blipworks/trilife/README.md

trilife
=======

Code and design files for Trilife cellular automata blinking LED project.
Initial work supported by the National Science Foundation under
Grant No. 0644511.
