blipworks/trilife/PCB/Board_file_info.txt

Board file descriptions
Board revisions through the current version 1.3 are all inter-compatible in a single Trilife array and use the same bill of materials. Eagle 6 format.

IndividualTrilife_1_3.brd and .sch: Single version 1.3 board with improved LED silkscreen, and schematic

ConnectorBoard.brd : use one per every 2 trilife boards (of any version) if you want to create a rigid hexagonal array, instead of using jumper wires

ConnectorBoardWithPowerJack.brd : Has a power jack, but otherwise works like the ConnectorBoard. Traces and components are designed for a max of 4A 

Older files
Trilife1 board and schematic in Eagle 6.0. This is a single board and a power connector.

Trilife5 board; this is an array of the Trilife 1 that fits in the maximum free Eagle footprint and can be cut apart with PCB chopper--board and schematic aren't consistent because there are multiple copies.

Trilife5 Zipped files are the Gerber files to send to the board manufacturer for the arrayed board.
