blipworks/trilife/BuildInstructions/TrianglePaperPixel.pdf

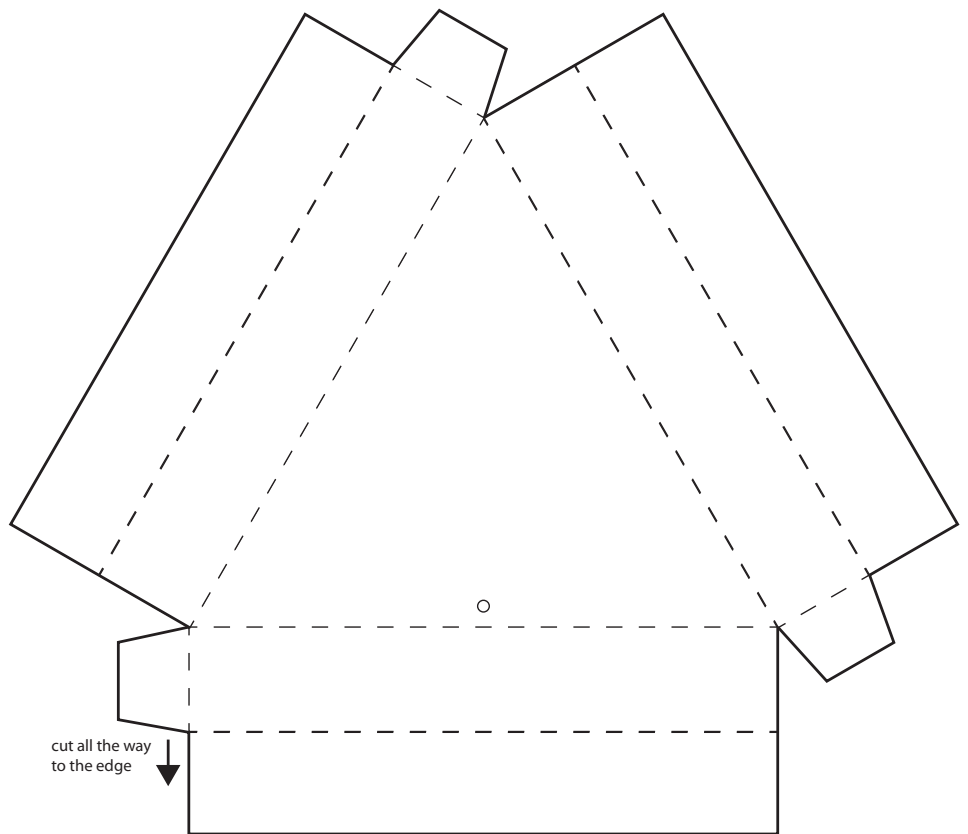
[picture p1: page 1]

cut all the way
to the edge
