blipworks/trilife/PCB/IndividualTrilife_1_3.brd

## EAGLE design PCB/IndividualTrilife_1_3.brd (2012-09-24)

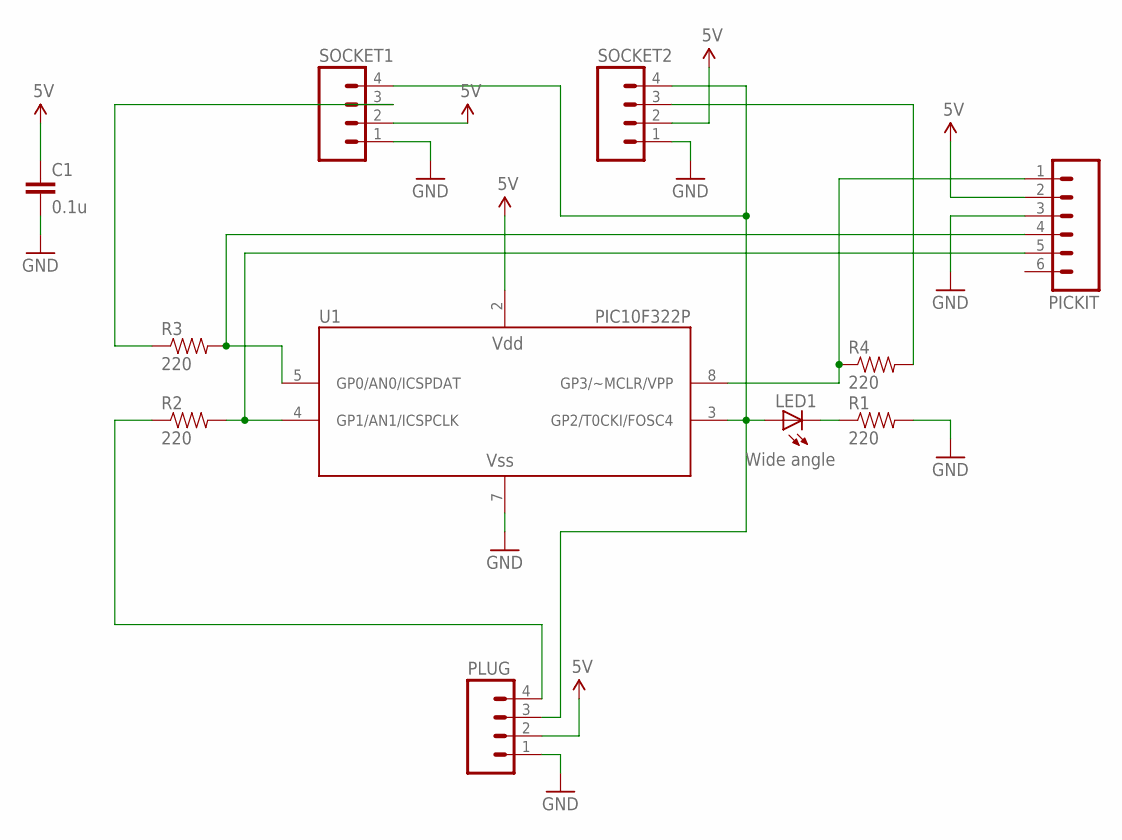
[picture p2: schematic IndividualTrilife_1_3.sch]

Parts:
C1: 0.1u; CAP-PTH-SMALL
LED1: Wide angle; LED5MM
PICKIT: M06LOCK; 1X06_LOCK
PLUG: M04LOCK; 1X04_LOCK
R1, R2, R3, R4: 220; AXIAL-0.4
SOCKET1, SOCKET2: M04LOCK; 1X04_LOCK
U1: PIC10F322P; DIP-8

Connections:
5V: C1.1, PICKIT.2, PLUG.2, SOCKET1.2, SOCKET2.2, U1.2 (VDD)
GND: C1.2, PICKIT.3, PLUG.1, R1.P$2 (2), SOCKET1.1, SOCKET2.1, U1.7 (VSS)
unnamed: LED1.A, PLUG.3, SOCKET1.4, SOCKET2.4, U1.3 (GP2/T0CKI/FOSC4)
unnamed: LED1.K (C), R1.P$1 (1)
unnamed: PICKIT.1, R4.P$1 (1), U1.8 (GP3/~MCLR/VPP)
unnamed: PICKIT.4, R3.P$2 (2), U1.5 (GP0/AN0/ICSPDAT)
unnamed: PICKIT.5, R2.P$2 (2), U1.4 (GP1/AN1/ICSPCLK)
unnamed: R4.P$2 (2), SOCKET2.3
unnamed: R3.P$1 (1), SOCKET1.3
unnamed: PLUG.4, R2.P$1 (1)

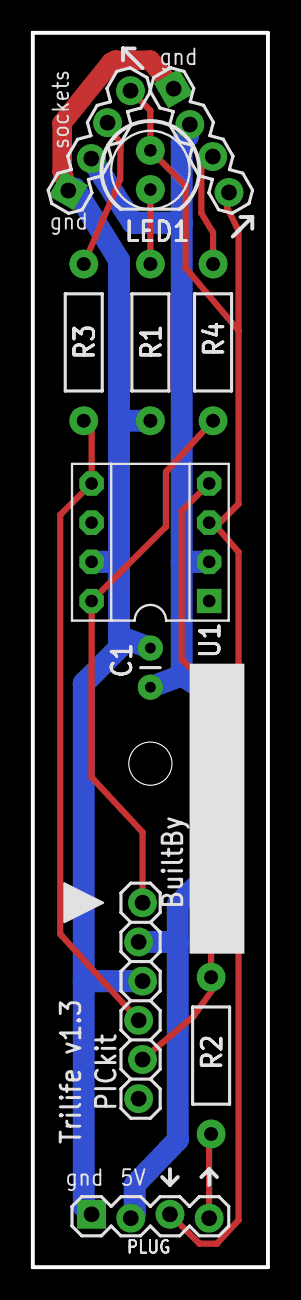
[picture p3: board IndividualTrilife_1_3.brd from above]

Board: 2 copper layers, 15.2 x 80.0 mm, 11 parts (0 on the bottom side), 10 nets.
