blipworks/trilife/PCB/Trilife_1.brd

## EAGLE design PCB/Trilife_1.brd (2012-04-29)

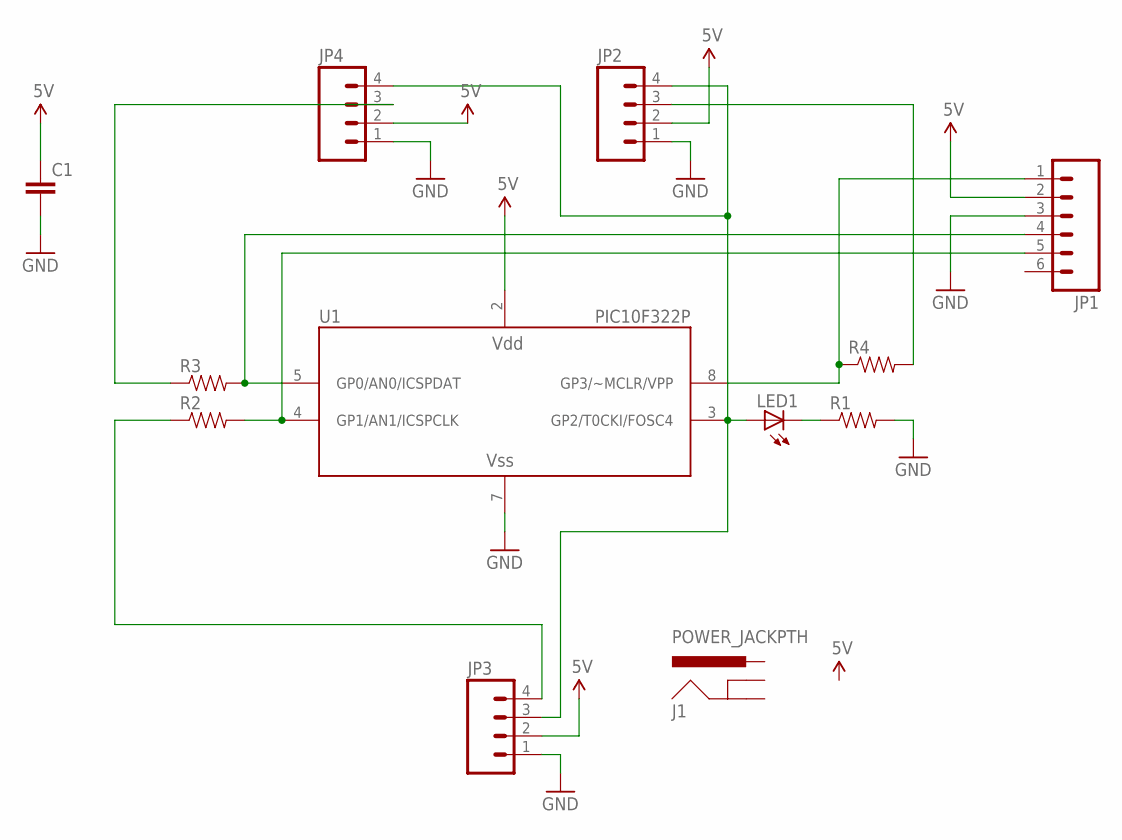
[picture p4: schematic Trilife_1.sch]

Parts:
C1: CAPPTH; CAP-PTH-SMALL
J1: POWER_JACKPTH; POWER_JACK_PTH
JP1: M06LOCK; 1X06_LOCK
JP2, JP3, JP4: M04LOCK; 1X04_LOCK
LED1: LED5MM
R1, R2, R3, R4: RESISTORPTH-1/4W; AXIAL-0.4
U1: PIC10F322P; DIP-8

Connections:
5V: C1.1, JP1.2, JP2.2, JP3.2, JP4.2, U1.2 (VDD)
GND: C1.2, JP1.3, JP2.1, JP3.1, JP4.1, R1.P$2 (2), U1.7 (VSS)
unnamed: JP2.4, JP3.3, JP4.4, LED1.A, U1.3 (GP2/T0CKI/FOSC4)
unnamed: LED1.K (C), R1.P$1 (1)
unnamed: JP1.1, R4.P$1 (1), U1.8 (GP3/~MCLR/VPP)
unnamed: JP1.4, R3.P$2 (2), U1.5 (GP0/AN0/ICSPDAT)
unnamed: JP1.5, R2.P$2 (2), U1.4 (GP1/AN1/ICSPCLK)
unnamed: JP2.3, R4.P$2 (2)
unnamed: JP4.3, R3.P$1 (1)
unnamed: JP3.4, R2.P$1 (1)

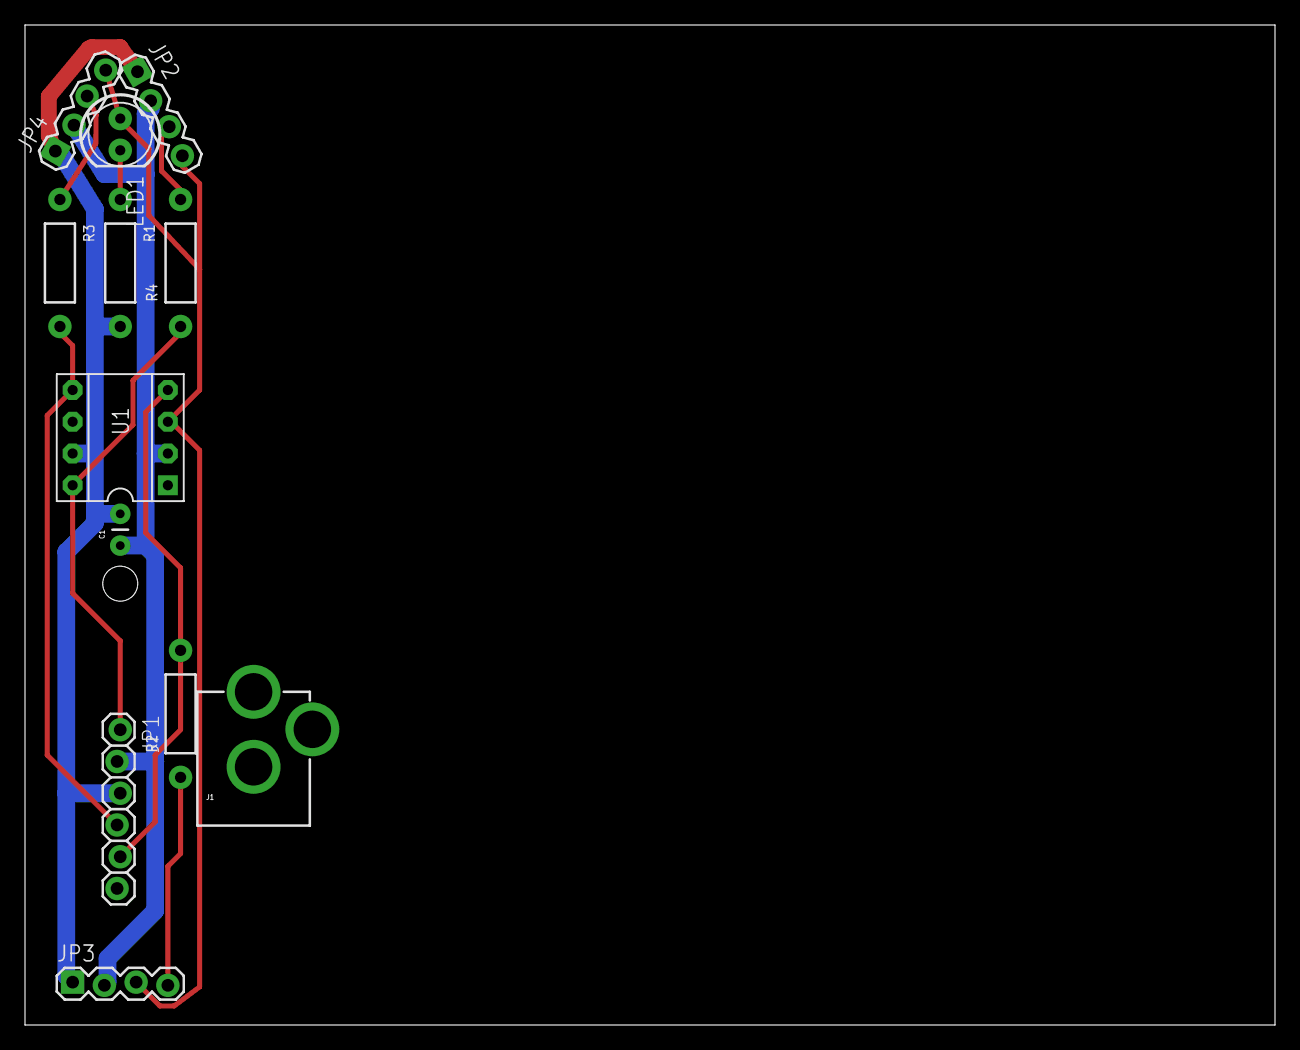
[picture p5: board Trilife_1.brd from above]

Board: 2 copper layers, 100.0 x 80.0 mm, 12 parts (0 on the bottom side), 10 nets.
