blipworks/trilife/PCB/Trilife_5.brd

## EAGLE design PCB/Trilife_5.brd (2012-04-29)

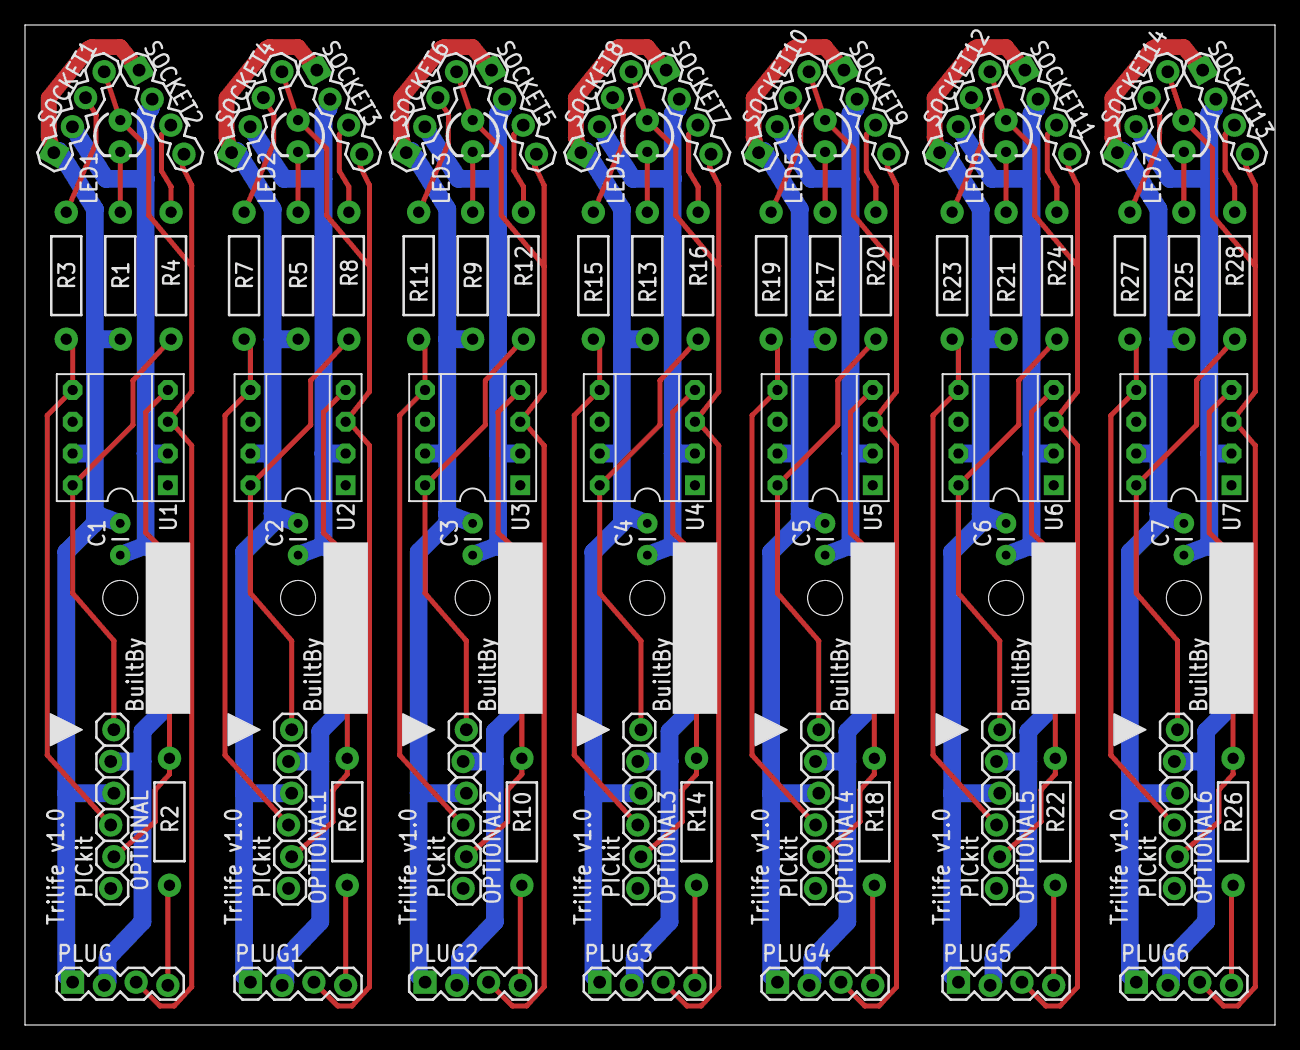
[picture p6: board Trilife_5.brd from above]

Board: 2 copper layers, 100.0 x 80.0 mm, 77 parts (0 on the bottom side), 70 nets.

Parts:
C1, C2, C3, C4, C5, C6, C7: CAP-PTH-SMALL
LED1, LED2, LED3, LED4, LED5, LED6, LED7: LED3MM
OPTIONAL, OPTIONAL1, OPTIONAL2, OPTIONAL3, OPTIONAL4, OPTIONAL5, OPTIONAL6: 1X06_LOCK
PLUG, PLUG1, PLUG2, PLUG3, PLUG4, PLUG5, PLUG6: 1X04_LOCK
R1, R2, R3, R4, R5, R6, R7, R8, R9, R10, R11, R12, R13, R14, R15, R16, R17, R18, R19, R20, R21, R22, R23, R24, R25, R26, R27, R28: AXIAL-0.4
SOCKET1, SOCKET2, SOCKET3, SOCKET4, SOCKET5, SOCKET6, SOCKET7, SOCKET8, SOCKET9, SOCKET10, SOCKET11, SOCKET12, SOCKET13, SOCKET14: 1X04_LOCK
U1, U2, U3, U4, U5, U6, U7: PIC10F322P; DIP-8

Connections:
5V: C1.1, OPTIONAL.2, PLUG.2, SOCKET1.2, SOCKET2.2, U1.2
5V1: C2.1, OPTIONAL1.2, PLUG1.2, SOCKET3.2, SOCKET4.2, U2.2
5V2: C3.1, OPTIONAL2.2, PLUG2.2, SOCKET5.2, SOCKET6.2, U3.2
5V3: C4.1, OPTIONAL3.2, PLUG3.2, SOCKET7.2, SOCKET8.2, U4.2
5V4: C5.1, OPTIONAL4.2, PLUG4.2, SOCKET9.2, SOCKET10.2, U5.2
5V5: C6.1, OPTIONAL5.2, PLUG5.2, SOCKET11.2, SOCKET12.2, U6.2
5V6: C7.1, OPTIONAL6.2, PLUG6.2, SOCKET13.2, SOCKET14.2, U7.2
GND: C1.2, OPTIONAL.3, PLUG.1, R1.P$2, SOCKET1.1, SOCKET2.1, U1.7
GND1: C2.2, OPTIONAL1.3, PLUG1.1, R5.P$2, SOCKET3.1, SOCKET4.1, U2.7
GND2: C3.2, OPTIONAL2.3, PLUG2.1, R9.P$2, SOCKET5.1, SOCKET6.1, U3.7
GND3: C4.2, OPTIONAL3.3, PLUG3.1, R13.P$2, SOCKET7.1, SOCKET8.1, U4.7
GND4: C5.2, OPTIONAL4.3, PLUG4.1, R17.P$2, SOCKET9.1, SOCKET10.1, U5.7
GND5: C6.2, OPTIONAL5.3, PLUG5.1, R21.P$2, SOCKET11.1, SOCKET12.1, U6.7
GND6: C7.2, OPTIONAL6.3, PLUG6.1, R25.P$2, SOCKET13.1, SOCKET14.1, U7.7
unnamed: LED1.A, PLUG.3, SOCKET1.4, SOCKET2.4, U1.3
unnamed: LED1.K, R1.P$1
unnamed: OPTIONAL.1, R4.P$1, U1.8
unnamed: OPTIONAL.4, R3.P$2, U1.5
unnamed: OPTIONAL.5, R2.P$2, U1.4
unnamed: R4.P$2, SOCKET2.3
unnamed: OPTIONAL1.1, R8.P$1, U2.8
unnamed: R3.P$1, SOCKET1.3
unnamed: PLUG.4, R2.P$1
unnamed: OPTIONAL1.4, R7.P$2, U2.5
unnamed: OPTIONAL1.5, R6.P$2, U2.4
unnamed: LED2.A, PLUG1.3, SOCKET3.4, SOCKET4.4, U2.3
unnamed: LED2.K, R5.P$1
unnamed: R8.P$2, SOCKET3.3
unnamed: R7.P$1, SOCKET4.3
unnamed: PLUG1.4, R6.P$1
unnamed: OPTIONAL2.1, R12.P$1, U3.8
unnamed: OPTIONAL2.4, R11.P$2, U3.5
unnamed: OPTIONAL2.5, R10.P$2, U3.4
unnamed: LED3.A, PLUG2.3, SOCKET5.4, SOCKET6.4, U3.3
unnamed: LED3.K, R9.P$1
unnamed: R12.P$2, SOCKET5.3
unnamed: R11.P$1, SOCKET6.3
unnamed: PLUG2.4, R10.P$1
unnamed: OPTIONAL3.1, R16.P$1, U4.8
unnamed: OPTIONAL3.4, R15.P$2, U4.5
unnamed: OPTIONAL3.5, R14.P$2, U4.4
unnamed: LED4.A, PLUG3.3, SOCKET7.4, SOCKET8.4, U4.3
unnamed: LED4.K, R13.P$1
unnamed: R16.P$2, SOCKET7.3
unnamed: R15.P$1, SOCKET8.3
unnamed: PLUG3.4, R14.P$1
unnamed: OPTIONAL4.1, R20.P$1, U5.8
unnamed: OPTIONAL4.4, R19.P$2, U5.5
unnamed: OPTIONAL4.5, R18.P$2, U5.4
unnamed: LED5.A, PLUG4.3, SOCKET9.4, SOCKET10.4, U5.3
unnamed: LED5.K, R17.P$1
unnamed: R20.P$2, SOCKET9.3
unnamed: R19.P$1, SOCKET10.3
unnamed: PLUG4.4, R18.P$1
unnamed: OPTIONAL5.1, R24.P$1, U6.8
unnamed: OPTIONAL5.4, R23.P$2, U6.5
unnamed: OPTIONAL5.5, R22.P$2, U6.4
unnamed: LED6.A, PLUG5.3, SOCKET11.4, SOCKET12.4, U6.3
unnamed: LED6.K, R21.P$1
unnamed: R24.P$2, SOCKET11.3
unnamed: R23.P$1, SOCKET12.3
unnamed: PLUG5.4, R22.P$1
unnamed: OPTIONAL6.1, R28.P$1, U7.8
unnamed: OPTIONAL6.4, R27.P$2, U7.5
unnamed: OPTIONAL6.5, R26.P$2, U7.4
unnamed: LED7.A, PLUG6.3, SOCKET13.4, SOCKET14.4, U7.3
unnamed: LED7.K, R25.P$1
unnamed: R28.P$2, SOCKET13.3
unnamed: R27.P$1, SOCKET14.3
unnamed: PLUG6.4, R26.P$1
