blipworks/trilife/(commit log)

2012-09-24 Updated with improved LED silkscreen and added connector and power boards
    [ConnectorBoard.brd, ConnectorBoardWithPowerJack.brd, IndividualTrilife_1_3.brd, IndividualTrilife_1_3.sch]
2012-09-24 Added some info about simulating Trilife using JCASIM, www.jcasim.de
